Lardonsauvage1/roby-le-gentil-robot/tools/README.md

# `tools/` — outillage opérationnel du robot

Scripts qui font tourner Roby au quotidien. Jusqu'au 2026-07-20 ils vivaient **uniquement
dans les répertoires personnels** des deux machines, sans aucun contrôle de version : leur
seul filet de sécurité était une quarantaine de fichiers `.bak_*` horodatés. Trois semaines
de travail n'existaient qu'en un seul exemplaire, sur un seul disque.

```
tools/
├── pc/     exécuté sur le PC (sam-AtomMan) — MoveIt, inférence, collecte, visualisation
└── pi5/    exécuté sur le Pi5 (roby-desktop) — caméras, servos, tests bas niveau
```

La séparation est **par machine**, pas par thème : ces scripts contiennent des chemins et
des dépendances propres à leur hôte (`/home/roby`, bindings libcamera compilés, `venv`
lerobot du PC…). Un script `pi5/` ne fonctionne pas sur le PC et réciproquement.

## Les scripts restent utilisables depuis le home

Chaque fichier est **lié symboliquement** depuis le répertoire personnel :

```
~/roby_infer.py -> ~/ros2_ws/tools/pc/roby_infer.py
```

Les habitudes ne changent donc pas (`bash ~/roby_infer.sh` marche toujours), mais **le
fichier réel est versionné**. Les imports Python continuent de fonctionner : Python résout
le lien et place le **vrai** dossier en tête de `sys.path`, donc `from roby_oracle import fkT`
trouve son voisin dans `tools/pc/`.

⚠️ **Ne jamais remplacer un lien par une copie** (`cp` par-dessus, éditeur qui écrit un
nouveau fichier) : la modification sortirait du dépôt sans être vue. Éditer le fichier dans
`tools/`, ou vérifier avec `ls -l ~/roby_*.py` que ce sont toujours des liens.

## Point d'entrée unique : `roby`

Lancer, arrêter et piloter le robot passe par **`tools/pc/roby`** (lien `~/roby`). La procédure
de `/roby-lancer-bras` y est écrite en code : chaque étape qui agit est précédée de contrôles
(« portes », `pc/roby_gates.py`) qui arrêtent tout si l'état est faux.

```
roby status                   # tous les contrôles, sans rien toucher
roby up --nid-confirme        # lance tout (tête AU NID) ; refuse si le bras est hors du nid
roby sortie [--go]            # nid -> sortie, puis tête re-verrouillée et pince ouverte
roby jog | collecte | scene | rentrer [--go] | down [--hors-nid]
roby up --sim                 # MÊME chaîne en simulation, domaine 43 (jamais celui du bras)
```

Les programmes qui commandent le bras (jog, sortie du nid, prise d'outil/oracle, rejeux, séquences
MoveIt, garde) refusent aussi de démarrer si la stack est incohérente, même lancés à la main.
Chaque script prend son environnement dans `pc/roby_ros_env.sh` et son code **à côté de lui**
(jamais `~/roby_*.py`) : une copie du dépôt exécute toujours son propre code.

## Points d'entrée principaux

| Script | Rôle |
|---|---|
| `pc/roby_infer.py` / `.sh` | inférence réseau, modèles **joint** (5 articulations + pince) |
| `pc/roby_infer_cart.py` / `.sh` | inférence réseau, modèles **cartésiens** (pose TCP 6D + pince) |
| `pc/roby_vision.py` | prétraitement image **partagé** par les deux — ne pas dupliquer |
| `pc/roby_guard.py` / `.sh` | garde du corps : butées, vitesse, plancher, collision MoveIt |
| `pc/roby_oracle.py` | oracle de collecte (prise/dépose scriptée) |
| `pc/roby_collect_panel.py` / `.sh` | panneau de collecte du dataset (garder / jeter / relance) |
| `pc/roby_tool_pickup.py` | IK amortie DLS maison + séquence de prise |
| `pc/roby_sortie_nid.sh` + `.yaml` | trajectoire nid ↔ sortie, rejeu lent et sûr |
| `pc/roby_cam_view.py` / `.sh` | visualisation des 2 caméras (relais MJPEG, port 8081) |
| `pi5/cam_pub_pi2_dual.py` | **nœud caméra** : les 2 capteurs dans UN process (ISP partagé) |
| `pi5/launch_cams.sh` | lancement des caméras, avec garde anti-double-lancement |
| `pc/roby_env.sh` | environnement ROS du PC (Jazzy, CycloneDDS, domaine 42, pyenv neutralisé) — à sourcer |
| `pc/roby_fine_jog.py` / `.sh` | jog fin du vrai bras, lecture du TCP, capture de poses — envoie DIRECTEMENT à `arm_controller` : **ni garde ni MoveIt** (seul son anti-saut interne, aveugle à un état faux, cf. BUG-008) |
| `pc/roby_infer_panel.py` | panneau « modèle sur le bras » : garde + inférence (RTC, iGPU, CPU épinglés), case **Enregistrer les essais** (bag MCAP + fiche `.run.json`) |
| `pc/roby_rec_rollout.sh` | veilleur : enregistre les caméras pendant chaque essai du modèle (alternative à la case du panneau) |
| `pc/roby_rec_serie.py` | marque les N prochains essais enregistrés comme une série liée |
| `pc/roby_ov.py` | U-Net de la Diffusion Policy sur l'iGPU (OpenVINO) |
| `pc/roby_train_xpu.py` | entraînement Diffusion Policy sur l'iGPU (XPU), budget de temps fixe |
| `pc/roby_bag_to_lerobot.py` | conversion des bags en dataset LeRobot |
| `pc/roby_eval_offline.py`, `pc/roby_eval_pince.py` | évaluer un modèle sur un épisode enregistré, sans robot |
| `pc/roby_leader_node.sh` | nœud du **bras guide** SO-ARM 101 (`/dev/roby_leader`, couple coupé au démarrage) |
| `pc/roby_leader_panel.py` / `.sh` | panneau du bras guide : recentrage, échelle, embrayage, état et réarmement du garde |
| `pc/roby_leader_teleop_cart.sh`, `pc/roby_leader_teleop_pos.sh` | téléopération du bras **simulé** (cartésienne / en position) |
| `pc/roby_leader_teleop_reel.sh` | téléopération du **vrai** bras via le garde (US-023) — jamais essayée sur le matériel au 2026-09-13 |
| `pi5/pca_wake.sh` | réveil du PCA9685 après coupure d'alimentation — **fait bouger les servos** |

## Volontairement non versionnés

- `~/launch_stack.sh` (Pi5) et `~/start_robot.sh` (PC) : lanceurs **périmés**, documentés
  comme à ne plus utiliser (architecture A qui provoque la course au mock, ancienne IP).
- Les `*.bak_*` : remplacés par l'historique git (voir `.gitignore`).
