Lardonsauvage1/roby-le-gentil-robot/src/neuroneimitationcarote_description/meshes/visual/section4_maillage.stl

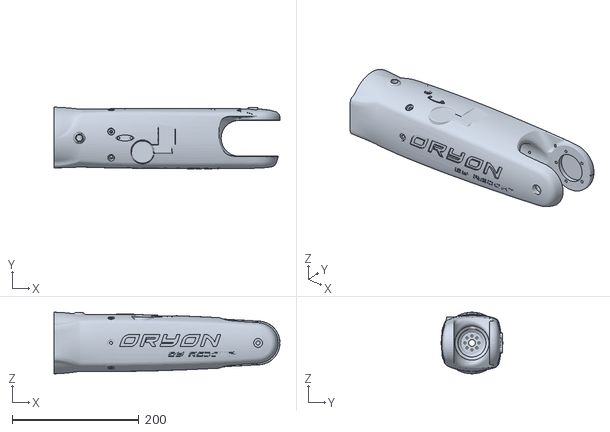
[picture p1: CAD file, 2026-09-06]
src/neuroneimitationcarote_description/meshes/visual/section4_maillage.stl
356.0 x 97.0 x 97.0
