Lardonsauvage1/roby-le-gentil-robot/src/roby_environments/meshes/support_robot.stl

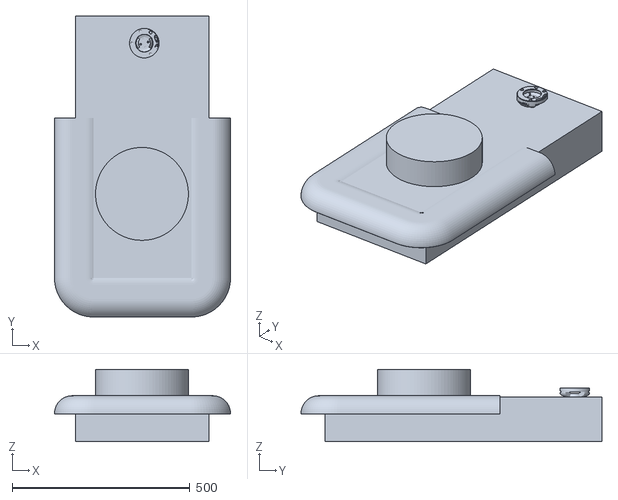
[picture p2: CAD file, 2026-09-21]
src/roby_environments/meshes/support_robot.stl
495.0 x 846.0 x 203.0
