Lardonsauvage1/roby-le-gentil-robot/src/neuroneimitationcarote_description/meshes/visual/section3_maillage.stl

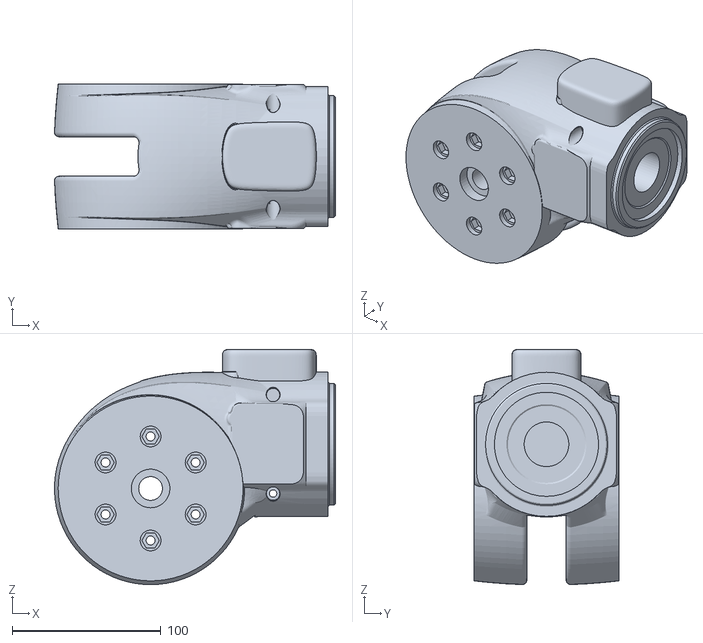
[picture p3: CAD file, 2026-03-29]
src/neuroneimitationcarote_description/meshes/visual/section3_maillage.stl
189.1 x 97.7 x 158.3
