Lardonsauvage1/roby-le-gentil-robot/src/neuroneimitationcarote_description/meshes/visual/section2_maillage.stl

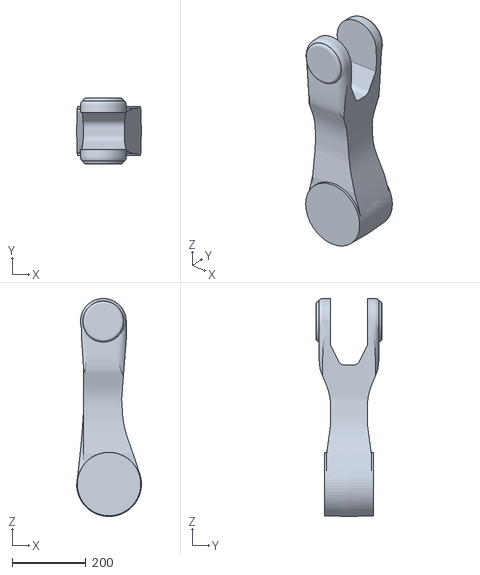
[picture p4: CAD file, 2026-03-29]
src/neuroneimitationcarote_description/meshes/visual/section2_maillage.stl
176.1 x 178.4 x 591.7
