Lardonsauvage1/roby-le-gentil-robot/src/neuroneimitationcarote_description/meshes/visual/section1_maillage.stl

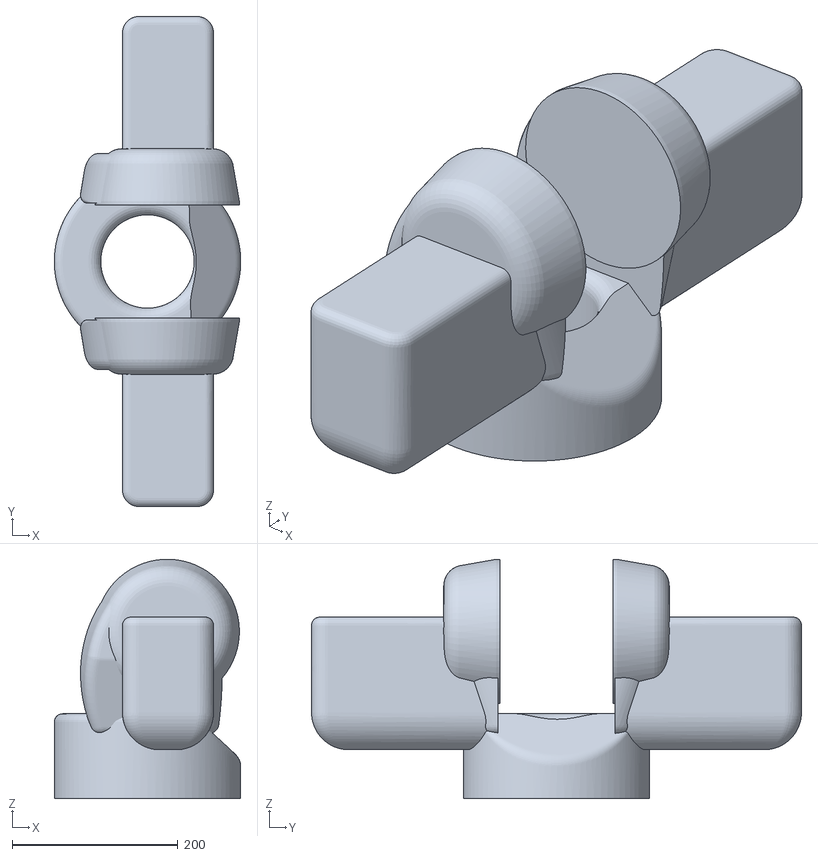
[picture p5: CAD file, 2026-03-29]
src/neuroneimitationcarote_description/meshes/visual/section1_maillage.stl
224.9 x 590.9 x 288.7
