Lardonsauvage1/roby-le-gentil-robot/src/neuroneimitationcarote_description/meshes/visual/section5_maillage.stl

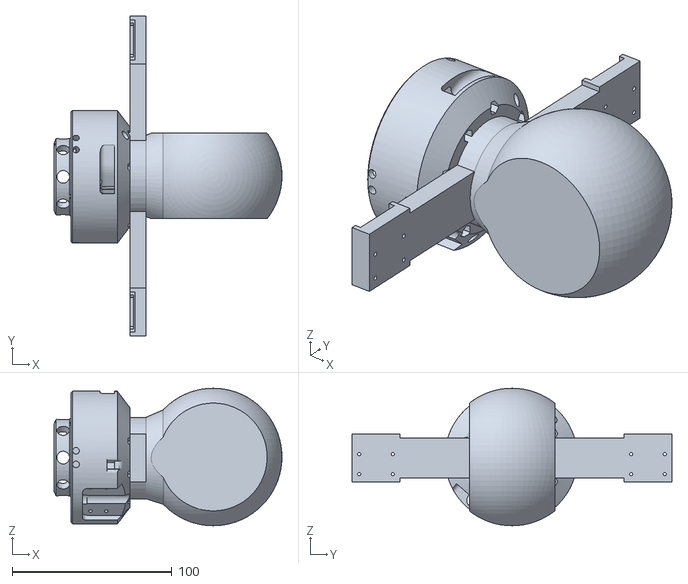
[picture p6: CAD file, 2026-03-29]
src/neuroneimitationcarote_description/meshes/visual/section5_maillage.stl
142.5 x 200.0 x 86.0
