Lardonsauvage1/roby-le-gentil-robot/src/neuroneimitationcarote_moveit_config/config/initial_positions.yaml

# Default initial positions for neuroneimitationcarote's ros2_control fake system

initial_positions:
  joint_1: 0
  joint_2: 0
  joint_3: 0
  joint_4: 0
  joint_5: 0
