Lardonsauvage1/roby-le-gentil-robot/(commit log)

2026-03-29 Initial commit: Roby le gentil robot — ROS2 workspace
    Bras 5 axes DIY pour imitation learning (behavioral cloning, LeRobot).
    Packages:
    - neuroneimitationcarote_description: URDF/Xacro + meshes STL
    - neuroneimitationcarote_moveit_config: MoveIt2 config + demo launch
    Fonctionnel:
    - Simulation mock_components (pas de hardware physique)
    - MoveIt2 planification (OMPL, CHOMP, Pilz, STOMP)
    - RViz avec interactive markers
    - Trajectoire en boucle (scripts/loop_trajectory.py)
    - Script de lancement (launch_sim.sh)
    [joint_limits.yaml, neuroneimitationcarote.ros2_control.xacro, neuroneimitationcarote.urdf.xacro, robot.urdf.xacro, ros2_controllers.yaml, section1_maillage.stl, section2_maillage.stl, section3_maillage.stl]
2026-05-30 Add roby_hardware package with encoder feedback (RS-485 + AS5048A)
    Initial commit of the roby_hardware ROS2 package (was untracked) including
    the new encoder monitoring chain developed today:
    - RobySystem plugin (ros2_control hardware interface for steppers + servos)
    - encoder_publisher.py: reads AS5048A via RS-485 (motors 1/2/3), publishes
    /joint_states_measured at 50 Hz with median filter + outlier rejection
    - encoder_calibration.yaml: zeros captured at arm initial pose (folded 90)
    - Encoder sign per axis calibrated empirically: motor_1 inverted, motor_2
    not, motor_3 inverted (each AS5048A magnet has its own orientation).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
    [encoder_calibration.yaml, roby_controllers.yaml, roby_hardware.ros2_control.xacro, roby_hardware_motor1_only.ros2_control.xacro, roby_hardware_steppers_only.ros2_control.xacro, roby_motor1_test.urdf.xacro]
2026-05-30 Add Pi5 deploy config + moveit_config rviz/launch updates
    - deploy/pi5/cyclone_config.xml: CycloneDDS config for Pi5 (autodetermine
    interface, peer list, no shared memory, max participant index 120).
    - deploy/pi5/README.md: full Pi5 setup procedure from fresh Ubuntu — UART0,
    GPIO udev rules, ROS2 install, calibration encoders, launch.
    - moveit_config: add rviz + launch variants for viewer-only / moveit-only
    modes, update moveit.rviz layout.
2026-05-31 Add encoder feedback (option B) in RobySystem + safety/coupling fixes
    EncoderDriver C++ class : async polling thread reads RS-485 AS5048A slaves at
    ~56 Hz, applies median filter (N=5) + outlier rejection (>20°/cycle), tracks
    multi-turn unwrapped, supports per-joint signs + coupling. Non blocking for
    ros2_control read() (~µs lookup vs 18ms sync poll). Loads encoder zeros from
    encoder_calibration.yaml via ament_index_cpp.
    RobySystem integration :
    - encoder_enabled param (default false, true in xacro). When enabled, state_interface
    position reflects real physical position (encoder), not step counter.
    - on_activate : warmup 250ms, then align stepper.current_steps_ on encoder
    reading (with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
    [roby_controllers.yaml, roby_hardware.ros2_control.xacro, roby_hardware_steppers_only.ros2_control.xacro]
2026-05-31 roby_hardware: closed-loop PID joint_2 + fiabilisation encodeurs (BUG-005)
    - PID closed-loop dans RobySystem (pid.hpp): feedforward trajectoire + correction
    encodeur; deadband anti-jitter (permet courant reduit au repos)
    - Filtre outlier encodeur avec porte de sortie (outlier_filter.hpp) anti lock-up
    - Reglage PID live via topic /roby/pid_gains (std_msgs)
    - Recalibration motor_2 (aimant recentre) + fix watchdog deviation joint_3
    - Outils diag: validate_encoders.py, jmon.py
    - Tests: test_pid, test_outlier_filter
    [encoder_calibration.yaml, roby_hardware_steppers_only.ros2_control.xacro]
2026-06-01 roby_hardware: closed-loop 3 axes + watchdog debounce + fix couplage + vitesse/accel
    - PID closed-loop sur les 3 axes (joint_1/2/3), gains graves (kp=0.15, deadband 0.03/0.04, ramp 0.02). Maintiens silencieux + tracking valides sur robot.
    - Fix signe encodeur joint_1 (joint_1_encoder_inverted=false) : corrige un runaway closed-loop (positive feedback) et la lecture open-loop inversee.
    - Watchdog deviation : debounce N=8 cycles (ignore les glitchs encodeur d un echantillon, garde la coupure runaway).
    - Fix couplage 2/3 : motor_3 compense la cible effective de joint_2 (commande + correction PID) => supprime la vibration parasite couplee.
    - on_pid_gains : applique la 6e valeur (deadband_ramp) +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
    [roby_hardware_steppers_only.ros2_control.xacro]
2026-06-02 Servos axes 4/5 + offset centre, deadbands steppers, fix race spawner
    - ServoDriver integre dans RobySystem : offset de centre servo (write/read/parse).
    joint_4 (PCA9685 CH0, 0-270 deg, offset 135) et joint_5 (CH1, 0-180 deg,
    offset 41.3, inverse) passes de mock a servo. 0 rad joint = centre mecanique.
    - Deadbands PID steppers elargis (j1/j3 0.06, j2 0.05) : bras tendu plus calme.
    - robot_full.launch.py : delais spawners 3->6 s, move_group 8->12 s. Corrige le
    race d'activation hardware/spawner (BUG-001) : les spawners tiraient avant que
    RobySystem soit active (retarde par le warmup encodeur), echec jsb/arm.
    Servos valides physiquement. EMI servo->encodeur resolue (cables eloignes).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
    [roby_hardware_steppers_only.ros2_control.xacro]
2026-06-08 Fix BUG-005: signe couplage axe 2/3 + watchdog open-loop, sync depuis Pi5
    Cause racine du decalage joint_3 en open-loop (BUG-005), trouvee en testant
    sur le vrai bras (encodeurs OFF, pas-a-pas sans perte de pas) :
    1. Signe du couplage inverse. La compensation mecanique correcte est
    motor3 = joint3_cmd + (20/32)*joint2 (K = 20/32 = 0.625, rapport des
    poulies du 2e etage 20T->32T ; le 1er etage 15/44 n'intervient pas car
    le 44T est libre sur l'arbre de l'axe 2). Le code appliquait un signe -.
    Fix : coupling_ratio_m2_num 6000 -> -6000. Valide physiquement
    (segment 3 reste fixe quand joint_2 bouge).
    2. Watchdog incoherent. write() pilote motor_3 a partir de joint_2.command
    (+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
    [encoder_calibration.yaml, roby_hardware_steppers_only.ros2_control.xacro]
2026-06-08 Demo presentation + fix couplage signe + fix overrun RT (a-coup axe 1)
    Scripts de demo (nouveau dossier demo/) :
    - demo_orchestrator.py : sequence init->A->verrou->B->pince->C->D->prise->
    E->depose->A->deverrou->init
    - demo_prep.py : preparation/montage tete (dry-run D->E->A)
    - demo_poses.yaml : poses init/A/B/C/D/E/mount (recapturees avec couplage corrige)
    - head_lock_node.py (PCA9685 CH2, verrou 75/deverrou 50)
    - gripper_node.py (pince fermer 55/ouvrir 120)
    Fixes driver (roby_hardware) :
    - Couplage axe 2/3 : signe inverse (coupling_ratio_m2_num 6000 -> -6000),
    K = 20/32 = 0.625 conforme a la derivation mecanique. Resout BUG-005.
    - Overrun boucle RT (a-coup visible axe 1) : les sleep_f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
    [roby_hardware_steppers_only.ros2_control.xacro]
2026-06-08 Demo: lanceurs PC (init/prep/demo+IHM) + sortie propre des scripts (os._exit)
2026-06-08 Fix overrun RT demo : priorite temps-reel + lock_memory + limite acceleration
    Cause de l a-coup violent au demarrage demo : boucle ros2_control non
    temps-reel (SCHED_OTHER) qui decrochait 1-3 s a la reception d un goal de
    trajectoire, puis rattrapait a vitesse max => ruee violente. Pas sautes en
    boucle ouverte.
    - controller_manager : lock_memory:true (mlockall, evite les defauts de
    page = hoquets ~90ms) + thread_priority:50 (prio FIFO explicite).
    (Cote systeme, hors repo : limits.d rtprio/memlock pour roby + gouverneur
    performance.)
    - safety_monitor : limite d acceleration (max_accel_rad_per_tick2, defaut 0
    = desactive) : tout rattrapage post-overrun rampe au lieu de sauter.
    clamp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
    [roby_controllers.yaml]
2026-06-12 Ajout du package roby_control : suivi du cube ArUco (robot simulé)
    Pilote le robot simulé (mock_components) en manipulant un cube ArUco devant
    la webcam, via une IK différentielle maison (MoveIt Servo étant inutilisable
    en cartésien sur le bras 5 axes).
    - aruco_node : détection cube DICT_4X4_50 (webcam), publie /cube_pose,
    /image_raw, /cube_marker, TF camera->cube. Rejet d'aberrations, image
    publiée réduite pour ne pas plafonner la détection (~30 Hz).
    - aruco_calibrate : calibre l'orientation des 6 faces via co-visibilité
    (rotations relatives, indépendantes de la caméra) -> config/cube_faces.yaml.
    - visual_servo_node : IK différentielle DLS amortie, PRIORITAIRE (position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
    [roby_servo.yaml]
2026-06-26 Drivers CL86Y axes 2/3 : DIR setup 5us + pulse groupe anti-overrun
    - stepper_driver: busy-wait DIR_SETUP_US (10us) apres changement de sens
    (le CL86Y exige DIR stable >=5us avant la 1ere impulsion PUL).
    - pulse groupe : write() leve/baisse ENSEMBLE les lignes STEP des moteurs
    en attente (busy-wait partage) au lieu de pulser chaque moteur separement
    => ~3x moins de spin CPU en multi-axes. Methodes has_pending_step /
    raise_step / lower_step_and_commit.
    - robot_control.launch.py : stack temps-reel seule (sans move_group, remonte
    sur le PC = reequilibrage archi PC<->Pi5).
    Valide sur robot : 3 axes + multi-axes fluides, sens correct, 0 overrun.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
    [roby_system.cpp, stepper_driver.cpp, stepper_driver.hpp]
2026-06-27 Modèle: butée axe 2 élargie, collision link_2/link_4 désactivée, package roby_environments
    - joint_2: limite -1.0/1.2 -> -1.6/2.1 (URDF robot.urdf.xacro)
    - SRDF: disable_collisions link_2 <-> link_4 (reason User)
    - Nouveau package roby_environments: environnements de collision chargeables
    dans la planning scene MoveIt (scene_loader: box/cylinder/sphere + couleurs ;
    environnement atelier_actuel.yaml mesuré).
    [robot.urdf.xacro]
2026-06-27 Fix: demarrage sur le nid sans mouvement violent (slew + contention I2C)
    Permet de demarrer le bras a une pose non nulle (le nid) sans slew.
    1. Slew au demarrage (joint_3) : l'alignement du compteur de pas sur la
    valeur couplee (compensate_coupling) en on_activate etait enferme dans
    if(encoder_enabled_). Encodeurs OFF => compteur joint_3 initialise
    non-couple alors que write() commande couple => mismatch => runaway.
    Fix: l'alignement compteur+couplage s'execute desormais TOUJOURS.
    2. Contention I2C (PCA9685) : ServoDriver::set_angle_deg ecrivait l'I2C a
    100 Hz, collision avec les nodes verrou/pince => bus fige. Fix: ecriture
    I2C uniquement quand la consigne PWM change (wr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
    [initial_positions.yaml, roby_system.cpp, roby_system.hpp, servo_driver.cpp, servo_driver.hpp, stepper_driver.cpp, stepper_driver.hpp]
2026-06-29 Scene atelier_actuel: armoire arasee au niveau table + coords table reelles
    - armoire_elec (boite rouge) : hauteur 1.06 -> 0.75 m, pose_z -0.410 -> -0.565
    => face haute alignee sur le dessus de la table (Z=-0.190), face basse
    inchangee (-0.940). Demande Sam.
    - commentaire table : valeurs marquees comme mesures reelles (calibration
    validee : robot ~7mm sur la table, hauteur socle<->table 13cm sim=reel).
    Note methode (cf memoire) : pour recaler un objet de scene sur le reel,
    toucher des points connus avec le robot calibre (frame contact = surface
    coupleur = link_gripper +3cm) et reporter dans le yaml. Socle = x,y a ~56mm
    (non corrige, decor).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
2026-06-29 Calibration: initial_positions = pose nid surface calibree
    Pose articulaire du nid apres calibration (frame contact = surface coupleur,
    ~7mm sur la table). Demarrage sur le nid sans slew (fix on_activate deja commite).
    [initial_positions.yaml]
2026-06-29 Outils de mouvement robot (jog, point-a-point MoveIt, prise d'outil DLS)
    Scripts ROS2 (PC, ~/) sauvegardes ici pour versionnement :
    - roby_fine_jog.py/.sh : jog fin + capture de poses + TCP cartesien
    - roby_moveit_seq.py/.sh : point-a-point MoveIt anti-collision (/move_action)
    - roby_tool_pickup.py/.sh : sequence prise pince, lignes droites IK amortie DLS
    maison (robuste singularites 5-DOF) + libre MoveIt. Valide sur hardware 2026-06-29.
    - capture_to_poses.py, roby_env.sh, roby_poses.yaml
    [capture_to_poses.py, roby_fine_jog.py, roby_moveit_seq.py, roby_tool_pickup.py]
2026-06-30 Regle vitesse/accel des moves libres MoveIt; axe 1 dedie
    Axe 1 (DM860I open-loop): vitesse 1.6 rad/s, accel 2.0 rad/s2 (reduits vs axes 2/3 closed-loop CL86Y a 3.2/6.4) pour limiter la vibration a l'acceleration et preserver la reference nid (pas de pas perdus).
2026-07-20 Servos verrou/pince : rampe, fiabilite I2C et reglage a chaud
    Regroupe le travail servo mene entre le 2026-07-17 et le 2026-07-20, jusqu'ici
    seulement sauvegarde en fichiers .bak_* horodates, sans aucun historique git.
    roby_system :
    - Rampe de commande servo (kServoRampDeg = 1.5 deg/cycle a 100 Hz) sur le verrou
    et la pince. Avant, un step brutal 70 <-> 110 faisait broutter le servo, surtout
    en cyclage rapide. Mesure : environ 0.27 s pour les 40 deg d'ouverture, donc trop
    rapide pour expliquer un retard visible a l'oeil ; tout retard restant est mecanique.
    - Topic /roby/gripper_deg (Float64, borne 40-130) : regle l'angle de serrage A CHAUD,
    sans rebuild ni redemarrage. Calque sur /r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
    [roby_hardware_steppers_only.ros2_control.xacro]
2026-07-20 Architecture B (PC = MoveIt/RViz), superviseur BT et migration reseau
    Regroupe le travail PC mene entre le 2026-06-26 et le 2026-07-20, jusqu'ici jamais
    commite. pc_moveit.launch.py notamment est utilise a CHAQUE session et n'existait
    que sur le disque.
    Architecture B (rebalancement PC <-> Pi5) :
    - pc_moveit.launch.py (NOUVEAU) : le PC lance move_group + RViz, le Pi5 garde le
    temps reel (robot_control.launch.py). Point critique documente dans l'en-tete :
    ce fichier ne lance PAS de robot_state_publisher, car un SEUL publisher de
    /robot_description est autorise, celui du Pi5 qui porte l'URDF hardware reel.
    Un rsp fantome sur le PC publierait l'URDF mock et le ros2_control_node du Pi5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
    [joint_limits.yaml]
2026-07-20 tools/ : met sous git les 80 scripts operationnels des deux machines
    Jusqu'ici ces scripts vivaient UNIQUEMENT dans les repertoires personnels du PC et
    du Pi5, sans aucun controle de version. Leur seul filet de securite etait une
    quarantaine de fichiers .bak_* horodates. Trois semaines de travail (collecte du
    dataset, inference, reglage de la pince, refonte camera) n'existaient qu'en un seul
    exemplaire, sur un seul disque, sans historique ni possibilite de revenir en arriere.
    Organisation par MACHINE, pas par theme : ces scripts embarquent des chemins et des
    dependances propres a leur hote (/home/roby, bindings libcamera compiles, venv lerobot
    du PC). Un script pi5/ ne tourne pas sur le PC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
    [encoder_calibration.yaml]
2026-07-20 Securite : vraies butees URDF dans le C++, butees manquantes, vitesse du garde
    Trois trous identifies par l'audit du 2026-07-20, dont un qui formait une chaine
    complete depuis une faute de frappe jusqu'aux moteurs.
    1. roby_system.cpp : les butees de position sont desormais LUES DANS L'URDF.
    Le code posait -M_PI/+M_PI en dur, sous un commentaire annoncant que "les
    vraies limites viennent du tag <limit> de l'URDF" -- code jamais ecrit. Le
    clamp materiel, derniere barriere avant les moteurs, ne protegeait donc rien :
    joint_2 butee reelle [-1.60, +2.10] clampait a +/-3.14 -> 88 deg au-dela
    joint_3 butee reelle [-3.00, +0.65] clampait a +/-3.14 -> 143 deg au-dela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
    [roby_goto_joints.py, roby_guard.py, roby_system.cpp]
2026-07-20 Echecs silencieux : boucle d'inference, desarmement garanti, garde-fou dimensions
    Trois modes de panne INVISIBLES identifies par l'audit du 2026-07-20. Aucun ne
    provoquait d'erreur : c'est precisement ce qui les rendait couteux.
    1. La boucle d'inference ne peut plus mourir en silence (roby_infer.py et
    roby_infer_cart.py).
    Elle n'avait aucun try/except. Un seul JPEG corrompu suffisait : imdecode
    renvoie None, le resize suivant leve, et le thread mourait DEFINITIVEMENT.
    Le timer de publication continuait alors a republier la derniere action
    indefiniment, le statut affichait toujours armed=True, et le bras tenait sa
    pose. Rien n'indiquait que le reseau ne pensait plus -- ind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
2026-07-20 Revert du clamp URDF dans le C++ : il bloquait l'axe 3 (couplage 2/3)
    Le commit 544c22e faisait lire les vraies butees URDF par le SafetyMonitor, a la
    place du -PI/+PI en dur. L'INTENTION reste juste -- le clamp materiel ne protege
    effectivement rien aujourd'hui -- mais la MISE EN OEUVRE etait fausse et a casse
    l'axe 3. Retour a l'etat connu comme fonctionnel.
    Ce qui s'est passe. Le clamp est applique a la commande COTE MOTEUR, apres la
    compensation de couplage (roby_system.cpp : compensate_coupling ligne ~854 puis
    clamp_command ligne ~868), mais avec des limites exprimees COTE ARTICULATION.
    L'axe 3 est couple mecaniquement a l'axe 2 (rapport 20/32 = 0.625) : sa valeur
    cote moteur n'a donc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
    [roby_system.cpp, roby_test_securite.py]
2026-07-20 Butees URDF appliquees en espace articulaire — cette fois PROUVE sur le materiel
    Deuxieme tentative du correctif annule en 69fd8a6, corrigee la ou elle etait fausse :
    le clamp de position s'applique desormais AVANT la compensation de couplage, la ou
    cmd est encore une position d'AXE et ou la limite URDF a donc un sens. Apres couplage
    la valeur est cote MOTEUR, avec un domaine decale par le rapport 2/3 (0.625) : c'est
    d'y avoir applique une limite d'axe qui epinglait joint_3 a sa butee et le rendait
    inerte.
    safety_.clamp_command() reste appele apres couplage et garde son role de limitation
    de VITESSE ; ses bornes de position (+/-PI) sont assez larges pour ne pas gener le
    domaine couple.
    V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
    [roby_system.cpp, roby_system.hpp, roby_test_securite.py]
2026-07-20 Code mort archive, fiches d'episode honnetes, deux bugs du panneau de collecte
    CODE MORT
    - Supprime src/roby_hardware/src/stepper_driver.hpp : duplicata JAMAIS compile (le
    .cpp inclut celui de include/, et le CMakeLists ne le mentionne pas), auquel il
    manque 5 fonctions dont le pulse groupe anti-overrun. Piege a lecture : qui l'ouvre
    croit lire le vrai driver. Reste dans l'historique git.
    - 14 scripts Pi5 deplaces dans tools/pi5/attic/ (versionnes, plus dans le chemin
    courant), avec un README expliquant pourquoi chacun est mort :
    * encodeurs RS-485 (9 fichiers) : le sous-systeme a ete RETIRE du projet ; le xacro
    charge declare encoder_enabled=false. Les trajectory_test*.py li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
    [roby_collect_panel.py, roby_infer_bag.py, roby_oracle.py, stepper_driver.hpp]
2026-07-20 Ménage : lanceurs du Bureau abandonnés, workspace Pi5 en double
    Trois zones manquees lors du premier passage, trouvees en elargissant la
    recherche au-dela des domaines couverts par les audits.
    1. tools/pc/attic/ : les 3 lanceurs du Bureau (roby_1_init, roby_2_prep,
    roby_3_demo), abandonnes depuis le 2026-06-26 et remplaces par les skills.
    Ils avaient ete versionnes PAR ERREUR dans tools/pc/ la nuit meme : ils
    faisaient partie des 48 scripts du home et je ne les ai pas reconnus comme
    obsoletes. Les skills font la meme chose AVEC les garde-fous que ces
    lanceurs n ont pas (balayage 2 machines, GATE anti-mock, GATE anti-race sur
    /robot_description, sequence de verrouillage a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
2026-07-20 roby_eval_offline.py : juger un modele sur un episode enregistre, sans robot
    Teacher-forcing sur un bag : le modele recoit les observations reelles et on
    compare sa prediction a ce que l oracle a fait au pas suivant. Sert a repondre
    a "le modele est-il bon ?" SANS engager le bras -- jusqu ici on ne pouvait
    repondre qu en le laissant piloter, ce qui melangeait la qualite du modele avec
    la latence, la camera et la pose de depart.
    Gere les deux familles (etat 5 ou 6, action 6 ou 7) et le detecte tout seul.
    Mesure : ecart de position, desaccords de pince, correlation de la descente.
    Limite explicite dans la docstring : ne dit rien de la tenue en boucle fermee.
    Un modele bon en teacher-forcing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
2026-07-20 Camera : une camera absente ne bloque plus le noeud entier
    pick() levait une exception si un capteur n etait pas enumere. Consequence :
    UNE nappe debranchee cote poignet empechait le noeud de demarrer et privait de
    flux la camera GAUCHE, pourtant saine -- alors que l inference n a besoin QUE de
    la gauche. Une panne materielle sur la camera inutile au modele bloquait donc
    tout le deploiement.
    Desormais : les cameras absentes sont sautees avec un avertissement nommant la
    consequence (inference OK, enregistrement d episodes impossible), et le noeud ne
    s arrete que si AUCUNE camera n est disponible.
    Les reglages de la camera gauche sont inchanges (exposition, gain, WB figes) :
    le rendu doit re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
2026-07-20 Pince : hysteresis 0.4/0.6 — corrige le claquement mesure a 65 ms
    Le modele sort une valeur CONTINUE pour la pince ; on la seuillait brutalement a
    0.5. Toute oscillation autour de ce seuil devenait un ordre d ouverture ou de
    fermeture.
    MESURE SUR LE ROBOT (b2cart_small_96, 30 s de pilotage reel, 2026-07-20) :
    14 changements d etat, dont des paires separees de 65 ms --
    291.640 OUVRE -> 291.706 FERME (66 ms)
    292.442 OUVRE -> 292.506 FERME (64 ms)
    302.840 OUVRE -> 302.908 FERME (68 ms)
    Le servo, provisoire et sous-dimensionne, etait cycle a ~15 Hz. C est le "la pince
    bugue un peu" rapporte par Sam. Le modele n y est pour rien : c est notre seuillage.
    Correctif : deux seuil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
    [roby_gripper.py, roby_gripper_monitor.py, roby_infer.py, roby_infer_cart.py]
2026-07-21 infer_cart : --exec-offset, choisir quelles actions du horizon executer
    Test de compensation de latence. generate_actions de LeRobot slice le horizon a
    actions[:, start:end] avec start = n_obs-1 (=1) : on execute le futur IMMEDIAT.
    Mais entre l image et l execution reelle il s ecoule le calcul (~270ms) + le
    pipeline async, donc ces actions correspondent a une position deja depassee. Cela
    explique le recul regulier observe.
    --exec-offset decale ce slice sans toucher au modele : offset=8 sur un horizon de
    16 execute les 8 DERNIERES actions = le futur plus lointain, qui tombe pile quand
    les actions sont reellement jouees. Reversible : -1 = defaut LeRobot d origine.
    Implementation : on remplac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
2026-07-21 infer joint : --steps configurable + b2_perf_128 (10 Hz, DDIM 5 pas)
    Le nouveau modele b2_perf_128 a change 3 parametres vs les b2_fixed :
    - cadence dataset 15 -> 10 Hz (nom du dataset : apple_b2_10hz_fixed_128) ;
    - scheduler DDPM -> DDIM ;
    - num_inference_steps 10 -> 5 (DDIM permet moins de pas sans perte).
    roby_infer.py forcait num_inference_steps=10 EN DUR et n avait pas d option. Sans
    correctif, lancer ce modele l aurait fait tourner a 15 Hz / 10 pas au lieu de
    10 Hz / 5 : le bras aurait bouge 1.5x trop vite avec un timing obs/action fausse,
    et on aurait conclu a tort que le modele est mauvais. Ajout de --steps ; --hz
    existait deja. A lancer : roby_infer.sh --model b2_perf_128 --hz 10 -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
    [roby_infer.py]
2026-07-22 OpenVINO iGPU : porte le U-Net sur l Intel Arc, debloque les gros modeles
    DECOUVERTE (mesures 2026-07-22) : ce PC (Core Ultra 9 185H) a un iGPU Arc et un
    NPU totalement inutilises (torch installe en version CPU-only). Le CPU deborde du
    cache au-dela d un certain U-Net -> scaling en params^2, le gros modele (263M)
    prend 2061 ms/inference = impossible en temps reel. L iGPU a sa memoire dediee.
    Mesure du MEME gros modele via OpenVINO sur l iGPU Arc :
    select_action complet, 5 pas : 2061 ms (CPU) -> 170 ms (iGPU) = x12.1
    dans le noeud ROS, 10 pas : 224 ms (budget 800 ms a 10 Hz -> large marge)
    Le modele le plus capable, qui etait INDEPLOYABLE, devient temps-reel.
    Fidelite VALIDEE : act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
2026-07-22 infer_cart : mode --sync (sense-plan-act) sur image fraiche
    Le pipeline async (defaut) infere en continu et bufferise : le bras agit sur des
    images perimees (retard perception-action ~340ms mesure). Le mode --sync fait un
    lot de n_action_steps actions sur une image FRAICHE, les execute TOUTES, puis
    re-infere sur une nouvelle image. Cree une pause pendant l inference (~250ms sur
    iGPU) mais le modele raisonne toujours a jour -- c est le mode d entrainement de
    la Diffusion Policy.
    Rendu possible par l iGPU : la pause de 250ms est supportable, la ou le CPU
    (2s+) rendait ce mode inutilisable.
    Implementation : _infer_loop_sync ne genere un lot QUE quand le buffer est vide
    (les 8 precedentes exec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
2026-09-06 Bras guide en joystick, cuisine 3D et zone de dataset
    Bras guide (US-017/018/019) — ids attribues, calibration, mode joystick
    Les 6 servos portent leurs identifiants et leurs bornes sont relevees. Le noeud
    `leader_node` publie l'etat du bras et gere son couple ; il est seul proprietaire
    du bus (verrou exclusif), demarre couple coupe et le coupe a l'arret.
    Le leader ne commande plus une position mais une VITESSE : chaque axe est rappele
    vers son zero avec un couple croissant, l'ecart devenant une consigne de vitesse.
    Cela regle du meme coup l'affaissement du bras (le rappel le tient) et les 124 deg
    de course inatteignables en correspondance 1:1.
    Trois pieges ont ete corriges dans le driv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
    [leader_calibration.yaml, robot.urdf.xacro, section4_maillage.stl, support_robot.stl]
2026-09-06 URDF : synchronise section 4 sur le Pi5 (maillage recentre + origine a zero)
    Le maillage section4_maillage.stl avait ete recentre cote PC, avec l origine
    visuelle de link_4 ramenee de -3.94046 0 0 a 0 0 0 pour compenser. Le Pi5
    gardait l ancien couple (ancien maillage + ancienne origine) : coherent avec
    lui-meme, mais RViz affiche l URDF publie par le rsp du Pi5 tout en resolvant
    les maillages sur le PC. Le croisement des deux projetait la section 4 a 4 m
    du robot.
    Les deux machines portent desormais le meme couple maillage/origine.
    Sauvegardes laissees non suivies : *.avant_recentrage et
    robot.urdf.xacro.avant_recentrage_link4.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
    [robot.urdf.xacro, section4_maillage.stl]
2026-09-06 sortie du nid : deverrouille la tete AVANT tout mouvement, dans les deux sens
    Le nid utilise le meme connecteur qu'un outil : verrou engage = tete retenue par
    le berceau. Sortir sans deverrouiller force sur le changeur d'outil. La consigne
    etait jusqu'ici a la charge de l'operateur (ou de la skill) ; elle est desormais
    dans la sequence elle-meme.
    --go publie /head_lock false, attend ROBY_UNLOCK_SETTLE (1.5 s par defaut) que le
    servo fasse sa course, puis seulement envoie la trajectoire. Applique aussi a
    --reverse : re-docker exige egalement le verrou ouvert.
    Fail-safe : si /head_lock n'a aucun abonne (RobySystem absent), le deverrouillage
    ne peut pas etre garanti et le script REFUSE de bou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
    [roby_sortie_nid.py]
2026-09-08 outils: banc roby_eval_pince.py -- juge le canal pince sans robot
    Le 2026-09-08 le bras fermait la pince en montant pendant les rollouts
    autonomes. roby_eval_offline.py ne voyait rien : il ne compare que la premiere
    action du chunk et annoncait "pince 100 %".
    Ce banc mesure les deux choses que l'autre masque :
    --mode chunk la vitesse du bras a l'instant ou le modele bascule la pince
    (le dataset y est a 0,0 mm/s ; le modele a 11 mm/s en moyenne)
    --mode global desaccords et nombre de bascules sur des episodes entiers
    (30 bascules predites pour 14 reelles)
    Piege traite explicitement : chaque select_action consomme une action de la
    file, donc on amorce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
2026-09-08 roby_ov: corriger un chiffre faux -- l'iGPU est x2,3, pas x12
    La docstring annoncait "CPU 2061 ms contre 170 ms sur l'iGPU, donc x12". Le
    263M a ete re-mesure a protocole propre (memes observations, 5 iterations de
    chauffe jetees puis 30 mesurees, machine au repos) :
    torch CPU 393,3 ms (ecart-type 34,7 | max 500)
    iGPU / OpenVINO 170,9 ms (ecart-type 10,9 | max 200)
    Le 170 ms de l'iGPU se confirme ; c'est le 2061 ms du CPU qui etait faux, issu
    d'une mesure unique sans chauffe. Le vrai facteur est x2,3.
    Note aussi ce qui justifie reellement le portage : pas la moyenne mais le MAX,
    face au budget de 533 ms. Le CPU depasse en conditions reelles (428-588 ms),
    l'iGPU p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
    [roby_ov.py]
2026-09-09 bras guide : calibration reglee en teleoperation simulee (2026-09-09)
    Reglages faits avec Sam, bras guide en main, robot simule dans RViz :
    axe 4 signe +1 -> -1 (sens inverse constate)
    axe 5 signe +1 -> -1 (sens inverse constate)
    axe 4 course_leader null -> 1,5708 rad
    axe 5 course_leader 3,6217 -> 1,8109 rad
    Sur l'axe 4, le gain n'etait pas le bon levier : l'axe est CONTINU, donc sans
    course mesuree le code retombait sur 180 deg par defaut et il fallait un
    demi-tour de poignet pour atteindre la vitesse maximale. Lui donner une course
    de reference le rend aussi vif que les autres. Meme methode sur l'axe 5, deja
    employee pour l'axe 1. Ce ne sont PAS des butees mecaniques, seuleme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
    [leader_calibration.yaml]
2026-09-09 bras guide : teleoperation en POSITION + outils de reglage a chaud
    Le mode joystick (vitesse) a ete juge trop mauvais a l'usage. Nouveau noeud
    leader_teleop_pos : le guide devient une maquette, sa pose devient celle de
    Roby. Il relit la calibration toutes les 0,5 s, ce qui rend le reglage des
    sens praticable -- on inverse, on regarde, on passe au suivant.
    Trois outils, tous a chaud, tous en ecriture atomique (le noeud relit ce
    fichier en continu, il ne doit jamais tomber sur un YAML tronque) :
    roby_leader_signe.py inverse le signe d'un axe
    roby_leader_zero.py capture les zeros sur la pose reelle du guide
    roby_leader_offset.py decale zero_urdf (le simule) ou zero (le guide)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
    [leader_calibration.yaml]
2026-09-09 teleop position : supprimer les demi-tours de la base sur la couture
    Symptome signale par Sam : le bras simule sautait sur une ou deux frames alors
    que le guide ne bougeait pas. Mesure, guide immobile 15 s :
    joint_1 226 sauts de 322 a 345 deg (les 4 autres axes : 0)
    Deux defauts distincts, tous deux revers de l'enroulement ajoute juste avant.
    Ils n'apparaissent que parce que le repos de la base tombe EXACTEMENT sur la
    couture (-180 deg), la base du guide etant montee a l'envers.
    1. Le lissage interpolait entre les NOMBRES, pas entre les angles. Le bruit
    d'un seul pas de codeur (0,088 deg) faisait alterner la consigne entre -180
    et +180 : la meme pose, mais le filtre passait PA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
    [leader_teleop_pos.py]
2026-09-09 calibration bras guide : etat propre, conforme a la spec
    Signes, zeros, echelles et zero_urdf verifies un a un contre la section
    'Calibration en vigueur' de spec-teleoperation-bras-guide. Echelles restaurees
    a leur precision de mesure d'US-019.
    Claude-Session: https://claude.ai/code/session_0134RSGp4tUTyNhNi5UAkk2w
    [leader_calibration.yaml]
2026-09-09 teleop cartesienne : ancrage complet, laisse, axes recopies, garde-fous
    Session de mise au point avec Sam, bras guide en main, robot simule.
    ANCRAGE. L'orientation etait absolue alors que la position etait ancree : au
    reembrayage, apres avoir tourne le poignet pendant le debrayage, le bras
    sautait. Mesure sur banc hors ligne : 10,4 mm ; apres correction, 0,00 mm sur
    trois scenarios dont une rotation pure et un grand deplacement. Les deux
    grandeurs sont desormais incrementales depuis l'ancre.
    DEUX ANCRES. Celle de commande est deplacee par la LAISSE pour empecher la
    divergence ; celle d'affichage ne bouge jamais entre deux embrayages. Avec une
    seule, les deux besoins etaient contradictoires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
    [leader_node.py, leader_teleop_cart.py, roby_leader_offset.py, roby_leader_panel.py]
2026-09-09 teleop cart : IK resolue dans le sous-espace actif, diagnostic corrige
    Sam trouve l'IK molle. J'ai suppose l'amortissement fixe (lam=0,06 partout,
    donc trop fort loin des singularites) et implemente un amortissement adaptatif.
    MESURE : aucun gain. Sur les 5 poses les plus mal conditionnees de 4000
    tirages (sigma_min jusqu'a 0,00092), les deux solveurs donnent le meme residu
    au dixieme de millimetre. Sur des pas de 5 mm -- le regime reel de la boucle,
    puisque la cible est laissee a 6 cm et ecretee a 0,25 m/s -- les deux donnent
    0,16 mm. L'hypothese etait fausse : pres d'une singularite le mouvement est
    reellement inatteignable dans cette direction, aucun lambda n'y change rien.
    Le changemen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
    [leader_teleop_cart.py]
2026-09-09 bras guide : neutre place sur la ZONE DE TRAVAIL (roby_leader_zero --roby travail)
    Sam trouve l'IK molle. Mesure : ce n'est pas le solveur (aucun gain possible,
    meme sur les poses les plus degenerees). C'est la POSE NEUTRE.
    Le neutre mettait le TCP a z = 0,64 m, tres au-dessus de la table, alors que la
    zone de travail reelle -- celle du dataset -- est a z = 0,33 m. On passait donc
    son temps a descendre, et le conditionnement se degradait en chemin : releve
    entre 0,009 et 0,019 en teleoperation, contre 0,25 au neutre.
    Nouveau neutre : TCP a z = 0,332 m, sigma_min 0,180. Bien conditionne ET a
    l'endroit ou le travail se fait.
    Deux precautions, chacune trouvee en verifiant AVANT d'appliquer :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
    [leader_calibration.yaml]
2026-09-09 roby_leader_zero : reparer la destruction de la calibration (variable masquee)
    Le mode --roby travail nommait sa variable d'offset `d`, qui ECRASAIT le
    document YAML charge sous le meme nom. En fin de fonction, safe_dump(d, ...)
    ecrivait donc le flottant du dernier axe -- 0.0 -- A LA PLACE DE TOUT LE
    FICHIER. Calibration de 198 lignes reduite a une ligne.
    Consequence observee : le noeud de teleoperation ne publiait plus rien du tout.
    Sans calibration exploitable, _cb sortait avant d'affecter self.guide, et _tick
    retournait donc avant de publier. Le bras simule etait fige, sans la moindre
    erreur dans les logs -- il n'y avait rien de casse, juste plus rien a convertir.
    Aggravant : j'ai commi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
    [leader_calibration.yaml]
2026-09-09 teleop cart : la laisse repositionne l'ancre au lieu de l'incrementer
    Symptome signale par Sam : "quand je lance le petit bras dans une direction, le
    grand continue d'y aller jusqu'a plus pouvoir". Le bras ne s'arretait jamais,
    meme main immobile.
    Cause : la laisse AJOUTAIT l'exces a l'ancre. Or l'exces se recalcule au tick
    suivant depuis la nouvelle ancre, et s'ajoute encore -- la cible restait donc
    eternellement une laisse devant la pince. Le bras poursuivait une carotte qui
    recule, jusqu'a la butee. Le correctif ecrit contre une divergence en creait
    une autre, dans l'autre sens.
    L'ancre est desormais REPOSITIONNEE pour imposer directement
    cible = actuel + laisse * direction, et s'en ded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
    [leader_teleop_cart.py, roby_leader_panel.py]
2026-09-09 bras guide : figer la configuration validee comme valeurs par defaut
    Reglages retenus apres la session de mise au point du 2026-09-09, pour qu'une
    relance simple reproduise l'etat qui fonctionne au lieu de repartir des
    defauts d'origine :
    axes_directs [1] figer aussi joint_5 creait une quasi-singularite
    permanente : il ne restait que 2 et 3, tous deux
    autour du meme Y, plus 4 qui est un roulis et ne
    deplace presque pas le TCP -- d'ou le manque
    d'autorite verticale signale par Sam
    offset_tcp_m 0,05 milieu de la boite de la pince
    w_ori 0,05 posi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
2026-09-09 bras guide : nouvelle pose de repos, plus haute (--zero-seulement)
    Sam voulait que le guide se gare plus haut, pour garder de la course vers le
    bas. Nouveau mode de roby_leader_zero qui capture UNIQUEMENT le zero du guide
    et preserve la correspondance cote Roby : aucun sens ne bascule, le grand bras
    ne saute pas.
    epaule 176,6 -> 155,5 deg (-21,1)
    coude 136,3 -> 131,4 deg ( -4,9)
    poignet 305,8 -> 303,4 deg
    rotation 222,5 -> 248,8 deg
    base inchangee a 175,2 deg
    Fichier relu et verifie apres ecriture : 6 articulations, echelles intactes.
    C'est desormais systematique -- une calibration mesuree ne se controle pas
    apres coup, cf. la destruction du fichier plus tot dans la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
    [leader_calibration.yaml]
2026-09-09 leader_node : relire la calibration a chaud, comme les noeuds de teleop
    Symptome : apres avoir deplace la pose de repos du guide, le RECENTRAGE le
    ramenait a l'ANCIENNE pose. Aucun message ne le signalait -- le fichier etait
    juste, mais le noeud gardait sa copie du demarrage.
    Le rechargement a chaud avait ete ajoute a leader_teleop_pos et
    leader_teleop_cart, mais pas a leader_node, qui est pourtant celui qui EXECUTE
    le recentrage. Le mode joystick avait le meme defaut, son rappel elastique
    visant ces memes zeros.
    Troisieme occurrence du meme mode d'echec dans la session : un reglage qui
    "ne prend pas" parce qu'un noeud garde une copie chargee au demarrage. Les
    trois noeuds relisent desorma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
    [leader_calibration.yaml]
2026-09-10 deploiement : modeles 7D, iGPU obligatoire, et rendre les pannes visibles
    Seance du 2026-09-10 sur le vrai bras. Il a fallu plus d'une heure pour faire
    tourner un modele qui fonctionnait deja le 8 septembre. Rien n'etait casse :
    trois pannes muettes se sont enchainees, et aucune ne laissait de trace.
    roby_infer_cart.py accepte desormais les modeles 7/7 en plus des 6/7. L'etat
    7D porte la pince en 7e composante, encodee 0 = ouverte, 1 = fermee -- releve
    dans le corpus, pas suppose. La valeur injectee est la DERNIERE COMMANDE
    envoyee, ce qui est exactement ce que le corpus enregistrait : l'oracle y notait
    sa commande, pas une mesure. Avant toute commande, la pince est ouverte, comme
    au debut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
2026-09-12 moveit.rviz : cadrage de la vue RViz (distance 2.64 -> 1.40, lacet)
    Changement de point de vue uniquement (camera RViz), aucun effet sur la
    planification. Fait lors d'une session precedente, commite tel quel le 2026-09-12.
    Claude-Session: https://claude.ai/code/session_01DjFuuNz2SS97Ye1HUrD4PN
2026-09-12 panneau d'inference : iGPU par defaut + epinglage P-cores (reduit les saccades, sans les supprimer)
    Seance du 2026-09-12 sur le vrai bras, modele du 8 septembre
    (propre_long_20260908/checkpoints/036000) : le bras avancait par a-coups.
    ERREUR CORRIGEE dans e39ccbd : son message annonce "iGPU obligatoire", mais le code
    du panneau laissait l'iGPU OPTIONNEL (--igpu seulement si ROBY_INFER_IGPU etait
    definie) et son commentaire affirmait que "le CPU tient le budget (0.368 s)". C'est
    faux en conditions reelles. Lance sans cette variable, le panneau inferait sur CPU.
    Mesures (meme modele, 10 pas de diffusion) :
    - vrai bras, CPU, sans epinglage ........... mediane 837 ms (budget 533 ms)
    - vrai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
    [roby_infer_panel.py]
2026-09-12 roby_rec_rollout.sh : enregistre les 2 cameras pendant chaque essai du modele
    Veilleur demande le 2026-09-12 : un bag MCAP par essai, du clic sur DEMARRER du
    panneau (detecte par l'apparition de roby_guard.py) jusqu'a l'arret du modele et
    du garde (STOP). Lecture seule, rien n'est envoye au bras. Tourne sous
    taskset -c 12-19 (E-cores) pour ne pas voler de temps a l'inference (P-cores).
    Topics : les 2 cameras compressees, /joint_states, sorties du modele
    (/roby_infer/action, gripper_raw, status) et consignes vers le garde.
    Sortie : ~/roby_datasets/rollouts/rollout_<date>/ + .log + .info (modele utilise).
    ETAT : syntaxe verifiee ; le veilleur est lance mais AUCUN essai reel n'a encore
    ete en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
2026-09-12 initial_positions : pose du nid recalee (joint_2/3/5), en service depuis le 2026-09-06
    Modification du 2026-09-06 04:36 restee non commitee sur le Pi5, commitee telle quelle
    le 2026-09-12. Valeurs precedentes conservees en copie non versionnee
    (initial_positions.yaml.avant_recalage_nid).
    joint_2 : 1.0083 -> 0.9179
    joint_3 : 0.3923 -> 0.4520
    joint_5 : 0.2251 -> 0.2009
    Constat du 2026-09-12 : au lancement de la stack (tete au nid), /joint_states lit
    exactement la pose attendue par /roby-lancer-bras (89.53 / 52.59 / 25.90 / 0.00 /
    11.51 deg), qui correspond a ces valeurs. En open-loop ce controle ne prouve PAS que
    le bras etait physiquement au nid : il prouve seulement que le fichier in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
2026-09-12 cam_pub_pi2_dual : mode BRUT par defaut (plus FIGE), plus de rotation sur left
    Version EN SERVICE sur le Pi5 depuis le 2026-09-06 (fichier modifie le 06/09 23:35),
    restee non commitee ; commitee telle quelle le 2026-09-12. ~/cam_pub_pi2_dual.py est
    un lien vers ce fichier, et ~/dual_node.log confirme les lancements "en mode BRUT".
    Contenu du changement (lu dans le diff, non re-teste par ce commit) :
    - defaut = BRUT (commente "decision Sam, 2026-09-06") : exposition AUTO, balance
    des blancs coupee avec gains 1.0/1.0, matrice couleur identite, saturation /
    contraste / luminosite neutres, accentuation 0, debruitage OFF ;
    - modes opt-in : ROBY_CAM_AUTO=1 (expo + WB auto), ROBY_CAM_F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
2026-09-12 ventouse : banc ventouse_test.py reecrit + sequences roby_ventouse.py (saisir/lacher)
    Fichiers du 2026-07-28 restes non commites sur le Pi5, commites tels quels le
    2026-09-12 (non re-testes par ce commit).
    ventouse_test.py (reecrit) : pilotage d'un canal PCA9685 en degres (--ch, --deg,
    --duree, --lecture, --alterne/--t-haut/--t-bas, --no-reset). Garde anti-contention
    reprise de lock_test.py : refuse de tourner si ros2_control_node est lance. Le fichier
    devient executable.
    roby_ventouse.py (nouveau) : --saisir / --lacher / --stop / --etat /
    --lacher-sans-vanne. Cablage selon l'en-tete du script, "verifie sur le banc le
    2026-07-28" : CH7 = electrovanne de relachement, CH8 = pompe a vide. Au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
    [roby_ventouse.py, ventouse_test.py]
2026-09-13 panneau d'inference : case « Enregistrer les essais » ; veilleur : arret SIGTERM, motif ancre
    Ce qui a tourne pendant la seance du 2026-09-13 (00:00-02:30) sur le bras reel.
    - roby_infer_panel.py : case « Enregistrer les essais ». Un bag MCAP par essai, du
    clic DEMARRER au STOP (la remontee n'est pas enregistree), sur les E-cores 12-19,
    avec une fiche .run.json/.run.md ecrite AU LANCEMENT (modele, checkpoint, mode
    RTC/async, accelerateur, CPU, j3_scale, commande exacte). Le resultat reste
    « A RENSEIGNER » : il est observe par l'operateur, jamais deduit.
    - roby_rec_rollout.sh (veilleur) : arret de l'enregistreur par SIGTERM. SIGINT etait
    ignore (processus lance en arriere-pla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
    [roby_infer_panel.py, roby_rec_serie.py]
2026-09-13 bras guide : teleoperation du VRAI bras via le garde (US-023, ADR-003 option B)
    Nouveau noeud leader_teleop_reel (sous-classe de leader_teleop_cart, dont le mode
    simulation ne change pas) : meme ancre incrementale, echelle, laisse et IK, mais la
    sortie part vers /guard/joint_trajectory en horizon glissant (2 points sur 80 ms,
    aucune extrapolation) et rien n'est publie sur /joint_states.
    Securite : embrayage refuse sans garde vivant / garde gele / garde sans MoveIt / second
    emetteur vers le garde / sans /joint_states frais ; retour en LIBRE sur flux du guide
    perdu, /joint_states perdu, garde gele, derive, saut de consigne ; plafonds 5 cm/s,
    0,4 rad/s, rotation 0,4 rad/s, echelle <= 1 ; planc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
2026-09-13 poignet axe 5 BLDC : driver Python, pont ros2_control, firmware SimpleFOC (US-027..030)
    Travail developpe les 2026-09-12/13 SANS le materiel (poignet non monte). Rien ne
    change tant que wrist:=servo (defaut) : l'URDF servo genere est identique octet pour
    octet, une valeur de wrist invalide est une erreur.
    - src/roby_wrist_bldc (nouveau) : protocole serie, generateur de consigne limite en
    vitesse/acceleration, detection du port, driver (thread lecteur, etat thread-safe,
    reconnexion, recalage au nid par Z, gestion des defauts), carte simulee, noeud ROS
    (/roby/wrist_bldc/{command,state,fault,status} + services), CLI, banc T1..T11,
    regle udev, config, launch.
    - roby_hardware : JointType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
    [roby_bldc_bridge_sim.urdf.xacro, roby_hardware_steppers_only.ros2_control.xacro, roby_motor1_test.urdf.xacro]
2026-09-13 cam_pub_pi2_dual : corrige les commentaires faux sur les cotes des cameras
    Aucun changement de comportement. left = camera du poignet (i2c@88000), right = vue
    exterieure (i2c@80000), verifie sur les images le 2026-09-13 ; le commentaire disait
    l'inverse. Les messages « l'inference n'a besoin que de left » etaient aussi faux
    depuis les modeles de septembre (camera right) : ils nomment maintenant
    ROBY_INFER_CAM.
    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
    [cam_pub_pi2_dual.py]
2026-09-13 roby_infer_panel : l'erreur de l'ecoute pince n'etait jamais affichee (NameError)
    Introduit par e39ccbd : dans _ecoute_pince, les deux « except Exception as e »
    affichaient l'erreur via une lambda executee plus tard par Tk. Python efface `e` a la
    sortie du bloc except : la lambda levait NameError et le message n'apparaissait
    jamais. Le message est maintenant fige dans le bloc. Trouve par analyse statique
    (pyflakes F821) et reproduit hors Tk.
    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
    [roby_infer_panel.py]
2026-09-13 tests roby_control : calibration en vigueur, domaine DDS propre a la teleop
    - test_leader_mapping : 3 tests echouaient depuis le 2026-09-09. Ils figeaient la
    calibration du 2026-09-05 alors que le fichier (qui fait foi, table « Calibration en
    vigueur » de spec-teleoperation-bras-guide) a change avec Sam en teleoperation
    simulee : joint_4 signe -1 (df8c071), joint_1 continu (fa2fe67), joint_5 zero_urdf
    +60 deg. Ils verifient maintenant les memes proprietes sur ces valeurs : signes
    retenus, jamais de consigne au-dela d'une butee de Roby, realignement qui echoue
    proprement hors de portee (axe 5, butee negative). Le plafonnement de l'axe 5 cote +
    est desormais attendu (correspond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
2026-09-13 bras guide simule : muet a cote d'un vrai robot (BUG-008, protection dans le code)
    BUG-008 (2026-09-10) : leader_teleop_cart, reste vivant 15 h sur le domaine 42,
    publiait la pose du bras SIMULE sur /joint_states a cote du joint_state_broadcaster du
    Pi5 ; le jog l'a recopiee, 38 deg de saut sur l'axe 1 du vrai bras. Les correctifs
    d'alors etaient procéduraux (balayage au lancement, GATE) ; le bug notait comme ouverte
    une protection permanente.
    Nouveau roby_control/sim_joint_states.GardeJointStates, utilise par les trois noeuds
    qui publient /joint_states (leader_teleop_sim, _pos, _cart) : silence pendant la
    decouverte DDS (2 s), puis publication seulement s'ils sont SEULS sur le topic ; sin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
    [leader_teleop_cart.py, leader_teleop_pos.py, leader_teleop_sim.py, sim_joint_states.py]
2026-09-13 deploiement : Pi5 et PC tels qu'en service, et ce qui vivait hors git
    Releve en lecture seule sur les deux machines le 2026-09-13.
    deploy/pi5/README.md : reecrit. L'ancienne version decrivait l'architecture d'avant
    juin 2026 (encodeurs AS5048A, esclaves Arduino RS-485, robot_full.launch.py), retiree
    du projet. Decrit maintenant l'architecture B (Pi5 = temps reel + cameras), le materiel
    (gpiochip4, CL86Y, PCA9685 CH0-3, ov5647 left = poignet / right = exterieure), les
    paquets reellement installes, la pile cameras (libcamera 0.5.2 compilee, stub pykms),
    le lancement et les pieges. Lacune declaree : les commandes de compilation de libcamera
    n'ont pas ete conservees.
    Nouveaux, copies a l'identi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
    [roby_leader_calib.yaml]
2026-09-13 menage : retire 16 copies de sauvegarde .avant_* commitees (restent dans l'historique)
    Copies de versions anterieures de scripts et de configurations, commitees le
    2026-09-09 (fa2fe67) a cote de leur fichier courant, qui existe toujours. Aucun code
    ne les lit ; seule NOTES_echelle_joint3.md en citait une, elle donne maintenant la
    commande git pour la ressortir. Toutes restent recuperables par
    `git show fa2fe67:<chemin>` :
    src/roby_control/config/leader_calibration.yaml.avant_{inversion_globale,zeros_neutre}
    tools/pc/roby_bag_to_lerobot.py.avant_{bicam,rognage}
    tools/pc/roby_dataset_to_cartesian.py.avant_decompensation
    tools/pc/roby_guard.py.avant_j3
    tools/pc/roby_infer_cart.py.ava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
2026-09-13 README a jour (architecture B, 6 paquets, securite) ; launch_sim.sh hors du domaine 42
    - README.md : decrivait encore 3 machines (Pi4 retire le 2026-06-26), des IP
    192.168.1.x et 2 paquets sur 6. Reecrit : architecture B, contenu du depot, lancement
    (renvoi a /roby-lancer-bras), regles de securite, tests, depots lies.
    - tools/README.md : points d'entree ajoutes (panneau d'inference et enregistrement,
    jog fin, bras guide et teleoperations, OpenVINO, entrainement, pca_wake).
    - launch_sim.sh : lancait un robot SIMULE (mock + robot_state_publisher) sur le domaine
    42, celui de la vraie stack : lance a cote du bras, c'est la course « mock ». Domaine
    43 par defaut (ROBY_SIM_DOMAIN_ID),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
2026-09-13 bras guide : trois defauts trouves en revue (reancrage perime, repere, panne du bus)
    Revue de code du 2026-09-13, defauts confirmes par experience avant correction.
    1. leader_teleop_cart : recharger la calibration (ou changer base_directe /
    axes_directs) pendant l'embrayage reancrait sur une pose du guide calculee avec
    l'ANCIEN reglage ; au message suivant, l'ecart devenait un vrai mouvement : 13 cm
    de TCP pour +10 deg sur le zero de la base, guide immobile (la base recopiee
    echappe a la laisse). Ces reglages sont maintenant appliques au PROCHAIN message du
    guide, avec le reancrage. Les outils roby_leader_offset/zero/signe editent ce
    fichier en direct : le cas est reel.
    2.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
    [leader_node.py, leader_teleop_cart.py, leader_teleop_reel.py]
2026-09-13 outils PC : defauts de securite trouves en revue (panneau, garde, oracle, nid, OpenVINO)
    Revue de code du 2026-09-13 sur les outils qui commandent ou observent le vrai bras.
    Securite :
    - roby_infer_panel : modele et garde tournent dans leur propre groupe de processus.
    Un panneau tue (Ctrl-C dans son terminal, terminal ferme, SIGTERM, plantage)
    laissait le modele piloter le bras SANS bouton STOP. Arret des processus sur
    SIGINT/SIGTERM/SIGHUP et a la sortie, SANS remontee (aucun mouvement lance par un
    arret anormal) ; teste : sortie en 0,11 s sur SIGTERM. SIGKILL reste non couvert.
    - roby_infer_panel : fermer la fenetre pendant les 4 s d'attente du garde laissait le
    modele se lancer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
2026-09-13 roby_hardware : fils arretes sur erreur et a la destruction ; attente BLDC 16 s
    Revue de code du 2026-09-13 du pont BLDC (aucun defaut bloquant : pas de saut, pas de
    course de donnees, rien de bloquant dans read()/write()). Corrige :
    - on_error / on_shutdown / destructeur : arretent les fils de fond (publication BLDC,
    executeur des abonnements). Sur le chemin d'erreur (watchdog d'ecart), le composant
    part en FINALIZED sans on_deactivate : le fil BLDC publiait la derniere consigne a
    100 Hz pour toujours (le noeud du poignet ne voyait jamais le silence qui l'arrete
    sur rampe), et les std::thread encore joignables provoquaient std::terminate a la
    sortie (deja vrai pour le fil de regl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
    [roby_hardware_steppers_only.ros2_control.xacro]
2026-09-13 teleop_reel_sim : la descente attend l'arret au plancher virtuel (plus de gel attendu)
    Depuis le plancher virtuel de la teleop, le bras s'arrete au-dessus du plancher du garde
    sans le faire geler ; l'etape « descente_table » descend tant que le bras descend, puis
    mesure la hauteur minimale et verifie l'absence de gel. Resultat sur le faux robot :
    25,4 mm au-dessus du plancher du garde, garde OK, toujours embraye.
    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
2026-09-13 simulation par le meme chemin que le vrai robot ; scene chargee au lancement (US-034)
    - robot_control.launch.py use_mock:=true (defaut false) : meme launch, meme URDF, memes
    controleurs, pose initiale = nid ; seul le materiel devient mock_components. Refuse sur le
    domaine 42. URDF par defaut verifie identique ligne a ligne (422 lignes) au
    /robot_description publie par le Pi5 en service.
    - pc_moveit.launch.py : scene:=cuisine chargee automatiquement (scene:=aucune pour s'en
    passer) ; elle vivait dans move_group et se perdait a chaque relance (seance d'essais du
    2026-09-13 sans scene). rviz:=false pour les essais sans ecran.
    - scene_loader : code retour non nul en cas d'echec (toujou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
    [roby_motor1_test.urdf.xacro]
2026-09-13 roby : point d'entree unique du robot, portes partagees (US-033, US-035)
    La procedure de /roby-lancer-bras n'existait qu'en texte, recopiee a la main ; trois textes
    divergeaient et les lanceurs perimes marchaient toujours. Elle devient du code.
    - roby_gates.py : les controles (domaine, materiel REELLEMENT charge via
    list_hardware_components, controleurs, publishers /robot_description et /joint_states,
    URDF publie, pose, nid lu dans le /robot_description, cameras, scene, validite). Lecture
    seule : aucune porte ne peut faire bouger le bras. Decisions pures « relance » et « arret ».
    - roby.py + lanceur roby : status, up, down, sortie, rentrer, jog, collecte, scene ;
    --sim = domaine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
2026-09-13 outils PC : chaque script execute son propre code et verifie la stack (US-036)
    - Les .sh prenaient $HOME/roby_*.py et $HOME/ros2_ws/install : lances depuis une autre
    copie du depot, ils executaient en silence le code EN SERVICE. Idem pour 15 scripts Python
    qui mettaient ~ en tete de sys.path (l'oracle d'une copie importait le roby_tool_pickup
    de l'autre). Code = les voisins du fichier ; donnees (roby_poses.yaml...) = le home.
    - Porte roby_gates au demarrage de roby_fine_jog, roby_sortie_nid (+ bras au 1er point de
    la trajectoire a 0,5 deg), roby_tool_pickup (donc l'oracle ; + scene), roby_goto_start,
    roby_goto_joints, roby_replay, roby_replay_cartesian, roby_moveit_seq (+ scene),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
2026-09-13 anciens lanceurs : refus du domaine 42 et renvoi a roby (US-037)
    - demo, moveit_only, rviz_only, rviz_viewer, rsp (URDF mock du moveit_config) et robot_full
    (architecture A) refusent le domaine 42 : a cote du vrai bras, c'est la course au mock.
    Verifie en appelant generate_launch_description (sans rien lancer) : refus sur 42,
    construction normale sur 43.
    - launch_sim.sh renvoie a roby up --sim.
    - roby_control.bringup refuse (il relancait le Pi5 sans verifier le nid) ; stack_spec
    signale ce qui y est perime. Le diagnostic en lecture seule reste.
    - Hors depot, le 2026-09-13 : ~/start_robot.sh (PC) et ~/launch_stack.sh (Pi5) remplaces
    par un refus, originaux en .perime_20260913.
    Co-A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
2026-09-13 roby_oracle : sans ROBY_J3_SCALE, avertir au lieu de refuser (decision de Niels)
    Le refus ajoute par la revue du 2026-09-13 bloquait toute collecte : aucun lanceur ne pose
    la variable. Niels, le 2026-09-13 : on collecte sans la compensation joint_3 pour l'instant.
    Le risque (derive de +-2 cm hors de D) est rappele a chaque lancement.
    Claude-Session: https://claude.ai/code/session_0187Ttw7QawW3jcZqaeAZY1B
2026-09-13 roby cameras : relancer les 2 cameras seules et verifier leur arrivee au PC
    Une camera peut mourir processus vivant (2026-09-13 : gauche a 0 Hz, droite a 15) ;
    roby up ne la relancait pas puisque le processus existait. Code de lancement partage avec
    roby up (lancer_cameras). Teste sur le vrai robot : 10 s, 15,5 / 15,0 Hz.
    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
2026-09-15 teleop cartesienne : l'IK pilote le CENTRE DU POIGNET, poignet recopie du guide
    Demande de Niels (2026-09-15) : piloter en cartesien la position de l'articulation du
    poignet, et non un point de la pince ou du changeur d'outil.
    - roby_tool_pickup.fk_poignet : origine de joint_5, deduite de fkT (une seule copie de la
    chaine). Elle est sur l'axe de roulis de joint_4 : ni joint_4 ni joint_5 ne la deplacent
    (verifie a 2e-16 m sur 2 000 poses).
    - leader_teleop_cart : point commande = centre du poignet, cote robot ET cote guide.
    joint_4 et joint_5 TOUJOURS recopies du guide, a 1:1 (l'orientation n'etait deja pas
    reduite par l'echelle) ; la base reste recopiee a l'echelle. L'IK ne resout pl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
2026-09-20 URDF mesuree + cinematique a source unique (ADR-005)
    La description du bras a ete re-mesuree et corrigee. A pose articulaire identique, la
    pince se deplace de 125 mm au nid : l'epaule descend de 5,87 cm et l'origine de joint_5
    quitte l'axe de roulis de joint_4 en prenant 9,9 cm en z.
    Le probleme n'etait pas l'URDF mais sa duplication : la meme chaine cinematique etait
    recopiee a la main dans trois fichiers Python sans aucun lien avec elle --
    roby_tool_pickup (teleop, oracle, inference, prise d'outil), roby_oracle (que la GARDE
    importe pour son plancher et son anti-collision) et visual_servo_node. Remplacer la seule
    URDF aurait laisse la garde proteger le bras avec une geometrie fausse de pl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
    [robot.urdf.xacro]
2026-09-21 Geometrie du bras corrigee, socle recale, nid re-etiquete
    Suite de l'ADR-005, avec NM en session sur la simulation.
    URDF — corrections successives, chacune verifiee contre la CAO :
    - joint_2 revient a z=0.203 (la valeur 0.1443 de l'URDF livree etait fausse) ;
    - joint_5 revient sur l'axe de l'avant-bras (z=0). L'URDF livree le placait 99 mm
    au-dessus ; trois sources independantes le contredisaient : l'emprise du maillage
    (50.5 mm hors matiere), l'axe de symetrie mesure dans le STL (z = 0.03 mm sur 24950
    facettes) et le volume de collision declare par l'URDF elle-meme (cylindre centre sur
    z=0). NM a confirme que l'avant-bras est droit ;
    - joint_gripper remonte de 2 mm (0.09432 -> 0.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
    [robot.urdf.xacro, support_robot.stl]
2026-09-30 Nettoyage cablage : une seule source (CABLAGE.md + xacro steppers_only)
    Apres le recablage du 2026-09-30 :
    - CABLAGE.md : fiche unique GPIO / I2C PCA9685 / USB / reseau, verifiee sur le robot ;
    deploy/pi5/README.md et README.md y renvoient.
    - Encodeurs RS-485 AS5048A retires du robot -> retires du code : encoder_driver,
    PID closed-loop, filtre outliers, recalage au repos, scripts, calibration, params xacro.
    Axes 2/3 = CL86Y boucle fermee interne, axe 1 = stepper boucle ouverte.
    - roby_hardware.ros2_control.xacro (doublon perime) et roby_hardware.launch.py
    (lanceur inutilise) supprimes ; gpiochip0 -> gpiochip4 dans les defauts et tests.
    - Firmware BLDC : la version flashee (test_bldc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
    [encoder_calibration.yaml, roby_bldc_bridge_sim.urdf.xacro, roby_controllers.yaml, roby_hardware.ros2_control.xacro, roby_hardware_steppers_only.ros2_control.xacro]
2026-09-30 poignet axe 5 : wrist:=bldc par defaut (poignet BLDC monte le 2026-09-30)
    robot_control.launch.py (Pi5) et pc_moveit.launch.py (PC) lancent desormais le
    poignet BLDC sans argument ; roby up en herite. wrist:=servo reste disponible
    pour l'ancien servo provisoire (demonte, PCA9685 CH1 libre). Le xacro garde servo
    comme repli pour les lanceurs de test moteur par moteur, qui ne demarrent pas le
    noeud du poignet.
    Tests : pont BLDC simule 3/3, outils PC 33/33, --show-args : default 'bldc'.
2026-10-10 Supprime l'ancien firmware du poignet (obsolete)
    Seule copie a jour : NIC_forge software/control/firmware/wrist_bldc_simplefoc
    (vitesse sur 5 ms contre le tremblement, attente du 12 V). Evite de flasher
    une ancienne version par erreur.
